robotronik/cdfr2019-2A/Electronique/Rolling_Base/Datasheets/Maxon_200142_Motor.png

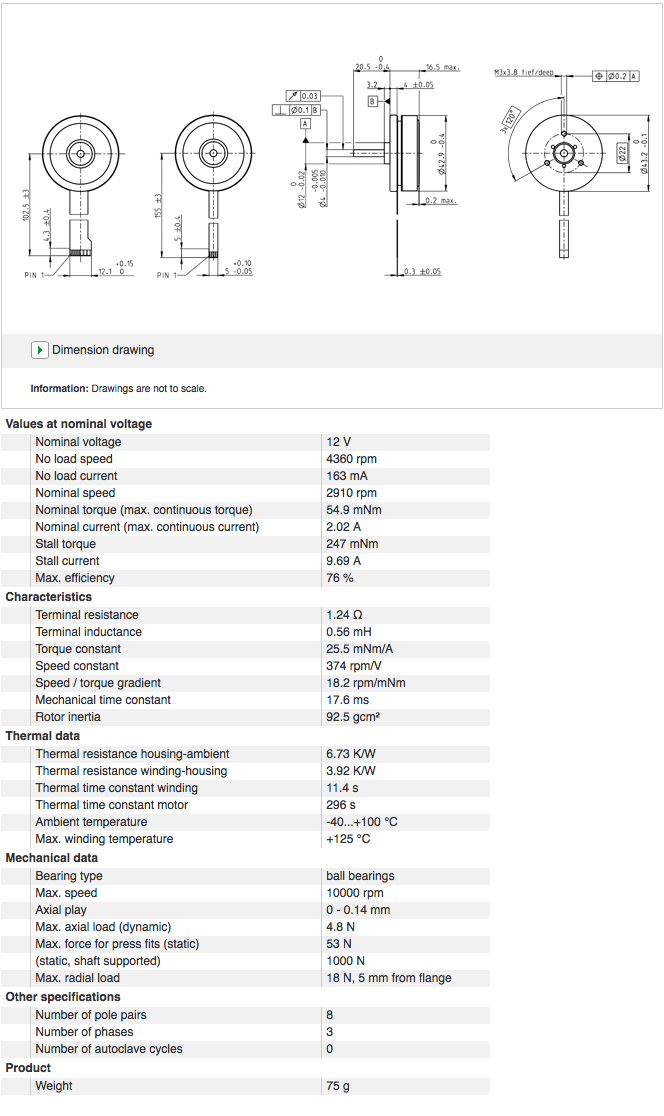
Electronique/Rolling_Base/Datasheets/Maxon_200142_Motor.png
