robotronik/cdfr2019-2A/Electronique/Power_Circuit/Power_Circuit.kicad_pcb

## KiCad design Electronique/Power_Circuit/Power_Circuit.kicad_pcb (2019-02-21)

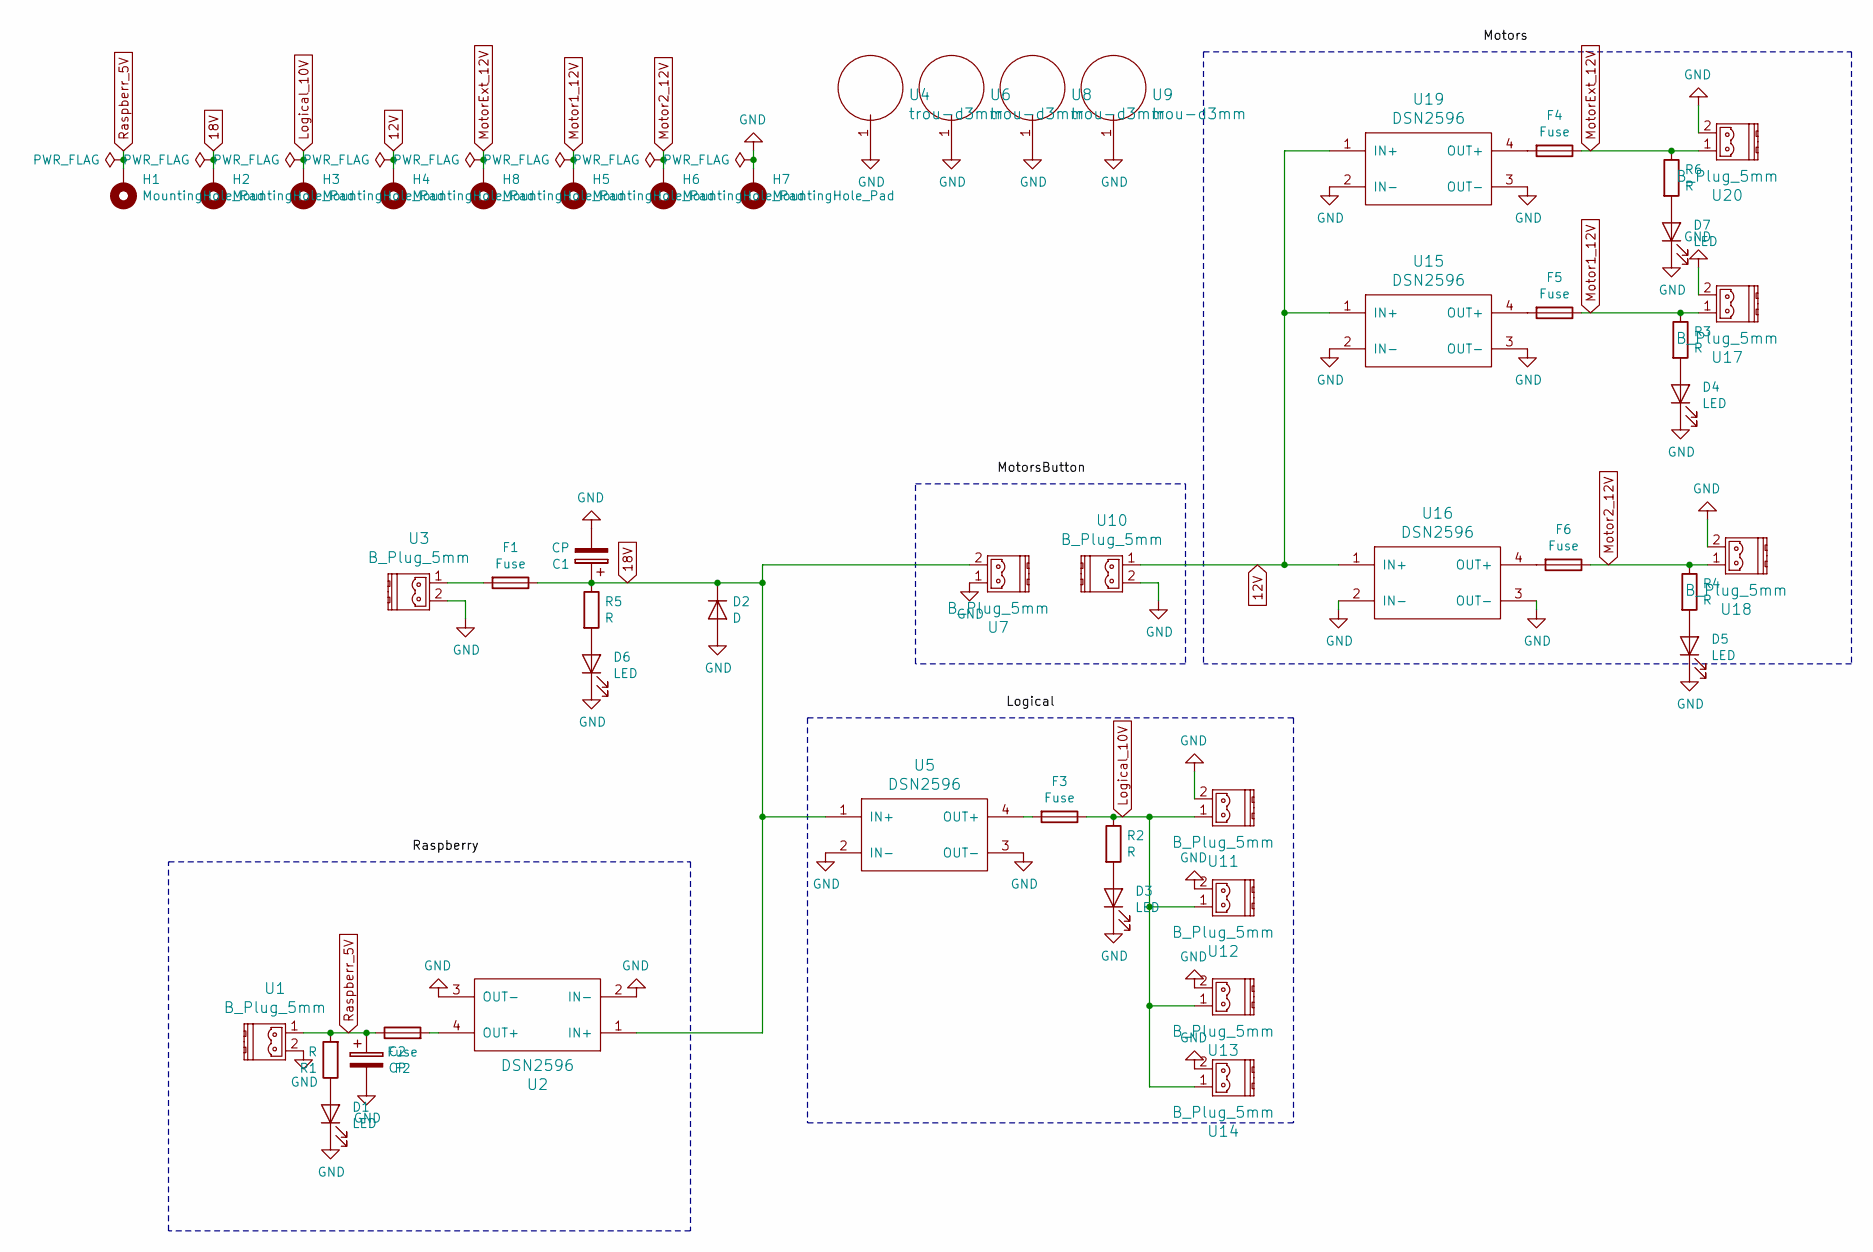
[picture p2: schematic Power_Circuit.sch]

Parts:
C1, C2: CP; CP_Radial_D8.0mm_P3.50mm
D1, D3, D4, D5, D6, D7: LED; LED_1206_3216Metric_Pad1.42x1.75mm_HandSolder
D2: D; D_DO-35_SOD27_P10.16mm_Horizontal
F1, F2, F3, F4, F5, F6: Fuse; Fuse_1206_3216Metric_Pad1.42x1.75mm_HandSolder
H1, H2, H3, H4, H5, H6, H7, H8: MountingHole_Pad; PinHeader_1x01_P1.00mm_Horizontal
R1, R2, R3, R4, R5, R6: R; R_1206_3216Metric_Pad1.42x1.75mm_HandSolder
U1, U3, U7, U10, U11, U12, U13, U14, U17, U18, U20: B_Plug_5mm; B plug 5mm
U2, U5, U15, U16, U19: DSN2596
U4, U6, U8, U9: trou-d3mm; trou_d3mm

Connections:
12V: H4.1, U10.1, U15.1 (IN+), U16.1 (IN+), U19.1 (IN+)
18V: C1.1, D2.1 (K), F1.1, H2.1, R5.1, U2.1 (IN+), U5.1 (IN+), U7.2
GND: C1.2, C2.2, D1.1 (K), D2.2 (A), D3.1 (K), D4.1 (K), D5.1 (K), D6.1 (K), D7.1 (K), H7.1, U1.2, U2.2 (IN-), U2.3 (OUT-), U3.2, U4.1, U5.2 (IN-), U5.3 (OUT-), U6.1, U7.1, U8.1, U9.1, U10.2, U11.2, U12.2, U13.2, U14.2, U15.2 (IN-), U15.3 (OUT-), U16.2 (IN-), U16.3 (OUT-), U17.2, U18.2, U19.2 (IN-), U19.3 (OUT-), U20.2
Logical_10V: F3.1, H3.1, R2.1, U11.1, U12.1, U13.1, U14.1
Motor1_12V: F5.1, H5.1, R3.1, U17.1
Motor2_12V: F6.1, H6.1, R4.1, U18.1
MotorExt_12V: F4.1, H8.1, R6.1, U20.1
unnamed: D1.2 (A), R1.1
unnamed: D3.2 (A), R2.2
unnamed: D4.2 (A), R3.2
unnamed: D5.2 (A), R4.2
unnamed: D6.2 (A), R5.2
unnamed: D7.2 (A), R6.2
unnamed: F1.2, U3.1
unnamed: F2.2, U2.4 (OUT+)
unnamed: F3.2, U5.4 (OUT+)
unnamed: F4.2, U19.4 (OUT+)
unnamed: F5.2, U15.4 (OUT+)
unnamed: F6.2, U16.4 (OUT+)
Raspberr_5V: C2.1, F2.1, H1.1, R1.2, U1.1

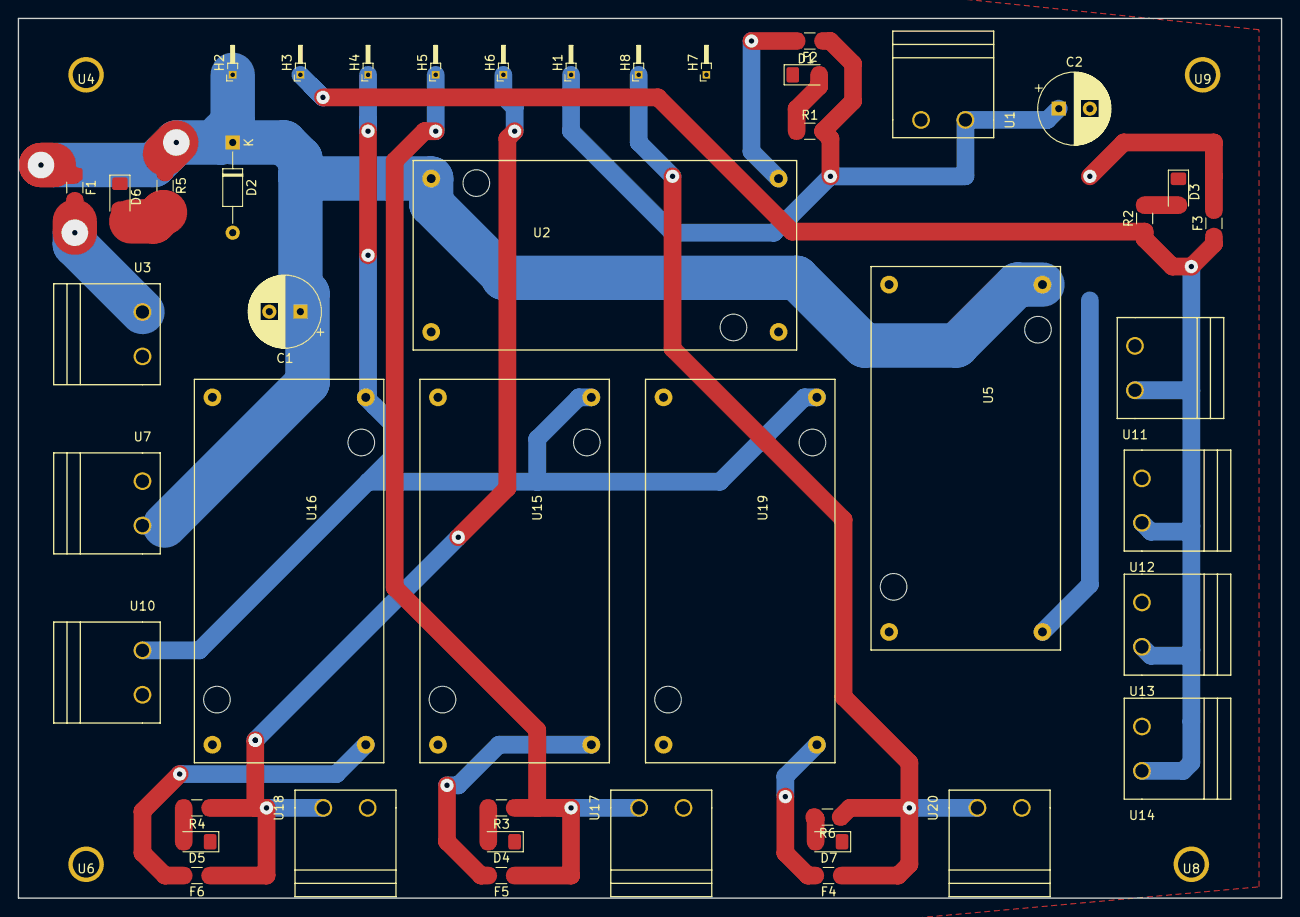
[picture p3: board Power_Circuit.kicad_pcb from above]

Board: 2 copper layers, 142.2 x 99.1 mm, 49 parts (0 on the bottom side), 20 nets.
