robotronik/cdfr2019-2A/Electronique/Rolling_Base/PCB/Motor_Card.kicad_pcb

## KiCad design Electronique/Rolling_Base/PCB/Motor_Card.kicad_pcb (2019-02-08)

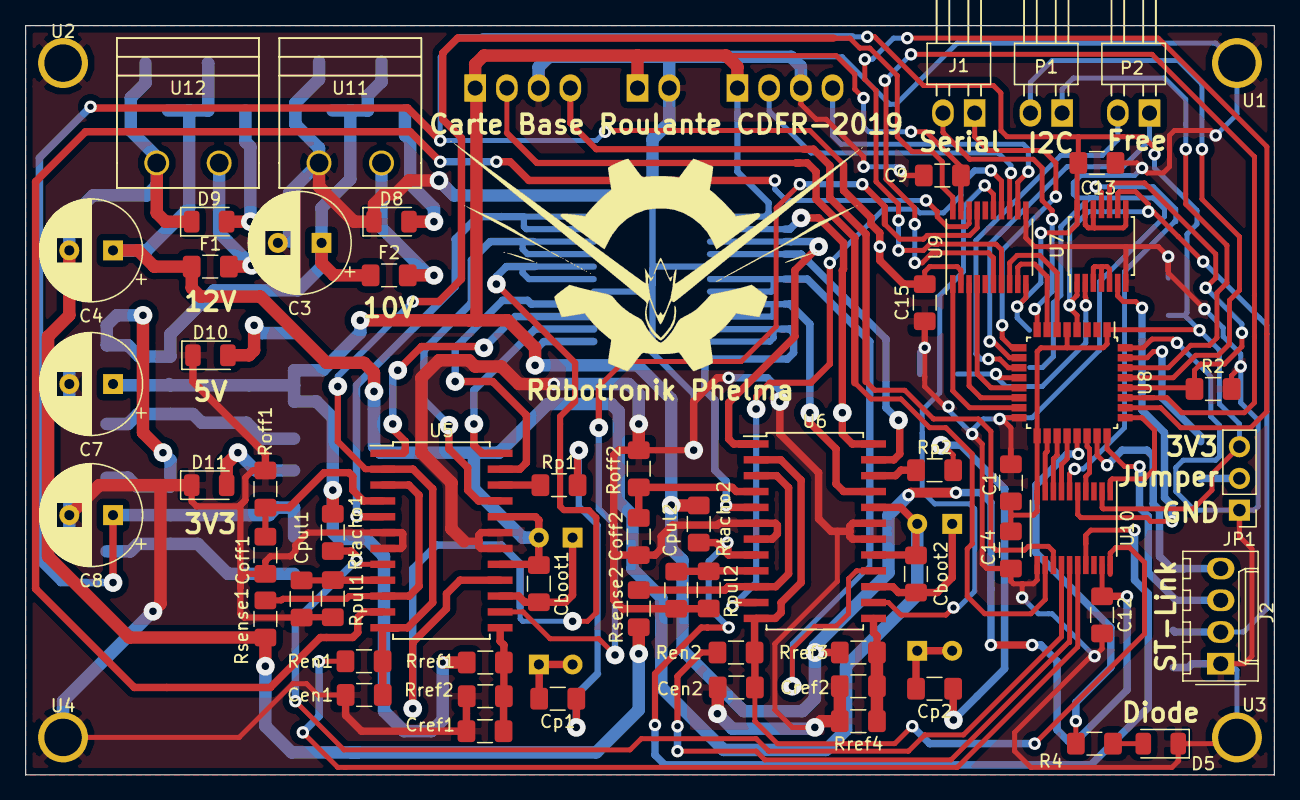
[picture p4: board Motor_Card.kicad_pcb from above]

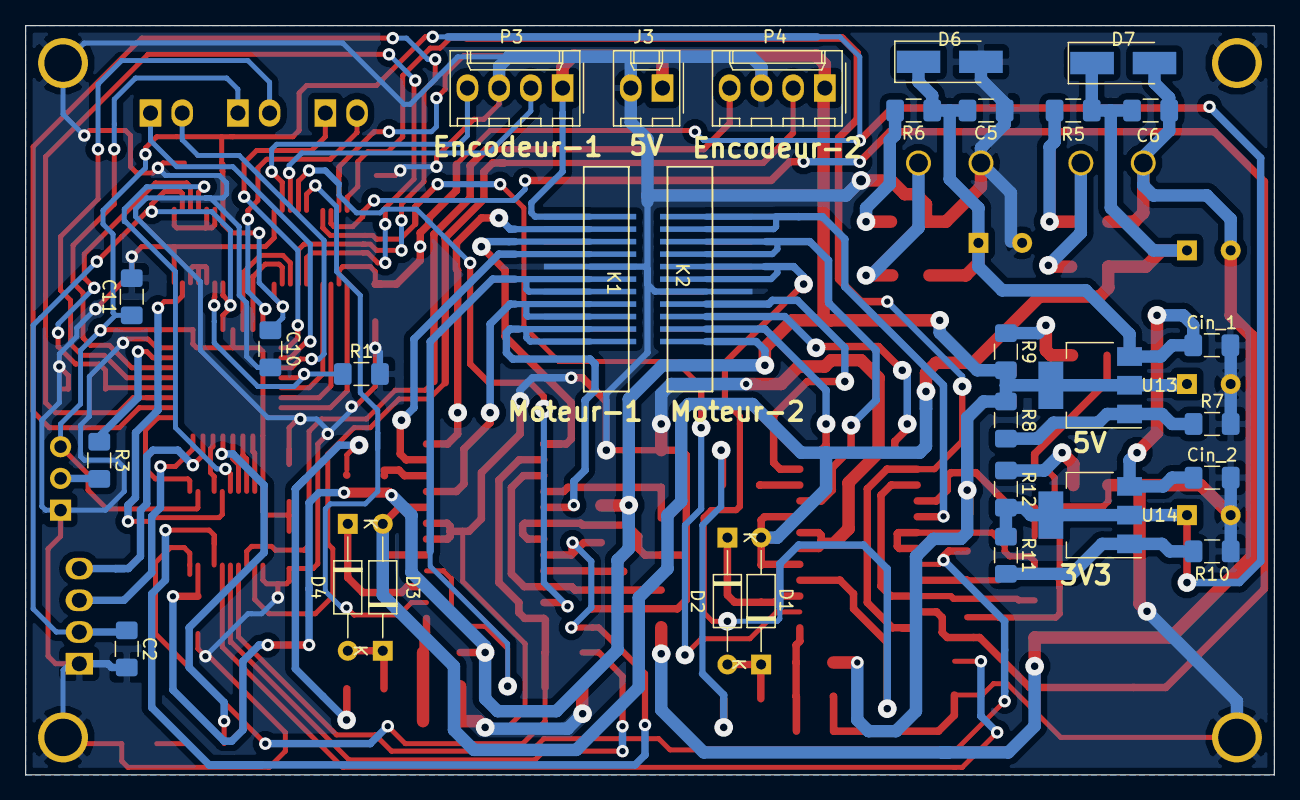
[picture p5: board Motor_Card.kicad_pcb from below]

Board: 2 copper layers, 100.0 x 60.0 mm, 94 parts (30 on the bottom side), 87 nets.

Parts:
C1, C2, C5, C6, C13, C14, C15: 100n; C_1206_3216Metric_Pad1.42x1.75mm_HandSolder
C3, C4: 100u; CP_Radial_D8.0mm_P3.50mm
C7, C8: 10u; CP_Radial_D8.0mm_P3.50mm
C9, C10, C11, C12: 0,1u; C_1206_3216Metric_Pad1.42x1.75mm_HandSolder
Cboot1, Cboot2: 220n; C_1206_3216Metric_Pad1.42x1.75mm_HandSolder
Cen1, Cen2: 5.6n; C_1206_3216Metric_Pad1.42x1.75mm_HandSolder
Cin_1, Cin_2: 0,1u; C_1206_3216Metric_Pad1.42x1.75mm_HandSolder
Coff1, Coff2: 1n; C_1206_3216Metric_Pad1.42x1.75mm_HandSolder
Cp1, Cp2: 10n; C_1206_3216Metric_Pad1.42x1.75mm_HandSolder
Cpul1, Cpul2: 10n; C_1206_3216Metric_Pad1.42x1.75mm_HandSolder
Cref1, Cref2: 10n; C_1206_3216Metric_Pad1.42x1.75mm_HandSolder
D1, D2, D3, D4: 1N4148; D_DO-35_SOD27_P10.16mm_Horizontal
D5, D9: LED_ALT; LED_1206_3216Metric
D6, D7: D_10A; D_SMA_Handsoldering
D8: LED_VCC; LED_1206_3216Metric
D10: LED_5V; LED_1206_3216Metric
D11: LED_3.3V; LED_1206_3216Metric
F1: Fuse_Puiss; Fuse_1206_3216Metric_Pad1.42x1.75mm_HandSolder
F2: Fuse_Num; Fuse_1206_3216Metric_Pad1.42x1.75mm_HandSolder
J1: CONN_SERIAL; Molex_KK-254_1x02_P2.54mm_Horizontal
J2: swdio; Molex_KK-254_AE-6410-04A_1x04_P2.54mm_Vertical
J3: FAN; Molex_KK-254_AE-6410-02A_1x02_P2.54mm_Vertical
JP1: Jumper_NC_Dual; PinHeader_1x03_P2.54mm_Vertical
K1, K2: Maxon-200142; Molex-52610-1133
P1: CONN_I2C; Molex_KK-254_1x02_P2.54mm_Horizontal
P2: CONN_FREE; Molex_KK-254_1x02_P2.54mm_Horizontal
P3: encoder_1; Molex_KK-254_AE-6410-04A_1x04_P2.54mm_Vertical
P4: encoder_2; Molex_KK-254_AE-6410-04A_1x04_P2.54mm_Vertical
R1, R2, R3: 10k; R_1206_3216Metric_Pad1.42x1.75mm_HandSolder
R4, R9, R12: 470; R_1206_3216Metric_Pad1.42x1.75mm_HandSolder
R5, R6: 2k; R_1206_3216Metric_Pad1.42x1.75mm_HandSolder
R7: 820; R_1206_3216Metric_Pad1.42x1.75mm_HandSolder
R8: 270; R_1206_3216Metric_Pad1.42x1.75mm_HandSolder
R10: 370; R_1206_3216Metric_Pad1.42x1.75mm_HandSolder
R11: 220; R_1206_3216Metric_Pad1.42x1.75mm_HandSolder
Ren1, Ren2: 100k; R_1206_3216Metric_Pad1.42x1.75mm_HandSolder
Roff1, Roff2: 33k; R_1206_3216Metric_Pad1.42x1.75mm_HandSolder
Rp1, Rp2: 100; R_1206_3216Metric_Pad1.42x1.75mm_HandSolder
Rpul1, Rpul2: 47k; R_1206_3216Metric_Pad1.42x1.75mm_HandSolder
Rref1, Rref3: 1.2k; R_1206_3216Metric_Pad1.42x1.75mm_HandSolder
Rref2, Rref4: 220; R_1206_3216Metric_Pad1.42x1.75mm_HandSolder
Rsense1, Rsense2: 0.3; R_1206_3216Metric_Pad1.42x1.75mm_HandSolder
Rtacho1, Rtacho2: 1k; R_1206_3216Metric_Pad1.42x1.75mm_HandSolder
U1, U2, U3, U4: Trou-3
U5, U6: L6235D; SOIC-24W_7.5x15.4mm_P1.27mm
U7: 74HC00; TSSOP-14_4.4x5mm_P0.65mm
U8: stm32f303k8t6; LQFP-32_7x7mm_P0.8mm
U9, U10: txb0108; TSSOP-20_4.4x6.5mm_P0.65mm
U11, U12: B_Plug_5mm; Bplug-5mm
U13, U14: LM317_SOT223; SOT-223-3_TabPin2

Connections:
+3V3: C1.2, C8.1, C10.1, C11.1, C13.1, C14.1, C15.2, JP1.3, R11.1, R12.2, U7.14, U8.1, U8.5, U8.17, U9.2, U9.10, U10.2, U10.10, U14.2
+5V: C7.1, C9.1, C12.1, J3.1, K1.11, K2.11, P3.1, P4.1, R8.1, R9.2, Rref1.1, Rref3.1, Rtacho1.1, Rtacho2.1, U9.19, U10.19, U13.2
+10V: C3.1, C5.1, Cin_1.1, Cin_2.1, D6.1, F2.1, R6.2, U13.3, U14.3
+12V: C4.1, C6.1, Cboot1.1, Cboot2.1, D1.2, D3.2, D7.1, F1.1, R5.2, U5.17, U5.20, U6.17, U6.20
/encodeurs/Ch_A1: U8.6, U9.8
/encodeurs/Ch_A1(+5V): P3.2, U9.13
/encodeurs/Ch_A2: U8.18, U10.9
/encodeurs/Ch_A2(+5V): P4.2, U10.12
/encodeurs/Ch_B1: U8.7, U9.9
/encodeurs/Ch_B1(+5V): P3.4, U9.12
/encodeurs/Ch_B2: U8.19, U10.8
/encodeurs/Ch_B2(+5V): P4.4, U10.13
/motor_part/BRAKE_1: U5.14, U9.17
/motor_part/BRAKE_2: U6.14, U9.15
/motor_part/DIAG_1: Cen1.2, Ren1.2, U5.2, U5.12, U9.20
/motor_part/DIAG_2: Cen2.2, Ren2.2, U6.2, U6.12, U10.20
/motor_part/DIR_1: U5.11, U9.18
/motor_part/DIR_2: U6.11, U9.14
/motor_part/EN_1: Ren1.1, U10.16
/motor_part/EN_2: Ren2.1, U10.15
/motor_part/Hall_sensor_11: K1.9, U5.1
/motor_part/Hall_sensor_12: K2.9, U6.1
/motor_part/Hall_sensor_21: K1.8, U5.23
/motor_part/Hall_sensor_22: K2.8, U6.23
/motor_part/Hall_sensor_31: K1.10, U5.24
/motor_part/Hall_sensor_32: K2.10, U6.24
/motor_part/Out_11: K1.1, K1.2, U5.5
/motor_part/Out_12: K2.1, K2.2, U6.5
/motor_part/Out_21: K1.3, K1.4, U5.21
/motor_part/Out_22: K2.3, K2.4, U6.21
/motor_part/Out_31: K1.5, K1.6, U5.16
/motor_part/Out_33: K2.5, K2.6, U6.16
/motor_part/TACHO_1: Rtacho1.2, U5.8, U10.14
/motor_part/TACHO_2: Rtacho2.2, U6.8, U10.17
/power_part/Alim_num: F2.2, U11.1
/power_part/Alim_puiss: F1.2, U12.1
/uC/Brake_1(3V3): U8.13, U9.4
/uC/Brake_2(3V3): U8.27, U9.6
/uC/Cmd_En_1(3V3): R1.1, U7.2, U8.12
/uC/Cmd_En_2(3V3): R2.1, U7.10, U8.28
/uC/Diag_1(3V3): U8.15, U9.1
/uC/Diag_2(3V3): U8.25, U10.1
/uC/Dir_1(3V3): U8.14, U9.3
/uC/Dir_2(3V3): U8.26, U9.7
/uC/Free_1(3V3): P2.1, U8.10
/uC/Free_2(3V3): P2.2, U8.11
/uC/I2C_SCL(3V3): P1.2, U8.29
/uC/I2C_SDA(3V3): P1.1, U8.30
/uC/RX(3V3): J1.1, U8.9
/uC/TX(3V3): J1.2, U8.8
/uC/Tacho_1(3V3): U8.20, U10.7
/uC/Tacho_2(3V3): U8.22, U10.4
/uC/nrst(3V3): C2.1, J2.2, U7.1, U7.9, U8.4
/uC/swclk(3V3): J2.3, U8.24
/uC/swdio(3V3): J2.4, U8.23
GND: C1.1, C2.2, C3.2, C5.2, C7.2, C8.2, C9.2, C10.2, C11.2, C12.2, C13.2, C14.2, C15.1, Cen1.1, Cen2.1, Cin_1.2, Cin_2.2, Coff1.1, Coff2.1, Cpul1.1, Cpul2.1, Cref1.2, Cref2.2, D5.1, D6.2, D8.1, D10.1, D11.1, J2.1, J3.2, JP1.1, K1.7, K2.7, P3.3, P4.3, R1.2, R2.2, R7.2, R10.1, Roff1.1, Roff2.1, Rpul1.1, Rpul2.1, Rref2.2, Rref4.2, U1.1, U2.1, U3.1, U4.1, U5.6, U5.7, U5.18, U5.19, U6.6, U6.7, U6.18, U6.19, U7.7, U8.16, U8.32, U9.11, U10.11, U11.2
GNDPWR: C4.2, C6.2, D7.2, D9.1, Rsense1.2, Rsense2.2, U12.2
unnamed: Cboot1.2, D2.1, U5.15
unnamed: Cboot2.2, D4.1, U6.15
unnamed: Coff1.2, Roff1.2, U5.4
unnamed: Coff2.2, Roff2.2, U6.4
unnamed: Cp1.1, Rp1.2
unnamed: Cp1.2, D1.1, D2.2
unnamed: Cp2.1, Rp2.2
unnamed: Cp2.2, D3.1, D4.2
unnamed: Cpul1.2, Rpul1.2, U5.9
unnamed: Cpul2.2, Rpul2.2, U6.9
unnamed: Cref1.1, Rref1.2, Rref2.1, U5.13
unnamed: Cref2.1, Rref3.2, Rref4.1, U6.13
unnamed: D5.2, R4.2
unnamed: D8.2, R6.1
unnamed: D9.2, R5.1
unnamed: D10.2, R9.1
unnamed: D11.2, R12.1
unnamed: JP1.2, R3.2
unnamed: R3.1, U8.31
unnamed: R4.1, U8.21
unnamed: R7.1, R8.2, U13.1
unnamed: R10.2, R11.2, U14.1
unnamed: Rp1.1, U5.22
unnamed: Rp2.1, U6.22
unnamed: Rsense1.1, U5.3, U5.10
unnamed: Rsense2.1, U6.3, U6.10
unnamed: U7.3, U7.4, U7.5
unnamed: U7.8, U7.12, U7.13
unnamed: U7.6, U10.5
unnamed: U7.11, U10.6
