robotronik/cdfr2019-2A/(threads)

Thread 8 (2019-01-16):

Gestion des branches

Salamandar, 2019-01-16:
Pourquoi vous réunissez élec, méca, et info dans le même repo en faisant plusieurs branches ? C'est pas le design de git !
Faites plusieurs repos, et utilisez les branches pour les features.

Thread 9 (2019-01-31):

Review des pull request (pour l'info)

robinmoussu, 2019-01-31:
Bonjour,
Je suis un ancien dev du club robot (même génération que Félix).
Si vous êtes intéressé, je peux faire des review du code que vous pusher sur le repo.
Robin
