robotronik/cdfr2019-2A/Electronique/Rolling_Base/prop.ioc

Mcu.UserName=STM32F303K8Tx
PA0.Signal=S_TIM2_CH1_ETR
PA1.Signal=S_TIM2_CH2
PA10.GPIO_Label=TACHO_1
PA10.Signal=GPIO_Input
PA11.GPIO_Label=LED
PA11.Signal=GPIO_Output
PA12.GPIO_Label=TACHO_2
PA12.Signal=GPIO_Input
PA15.GPIO_Label=DIAG_2
PA15.Signal=GPIO_Input
PA2.Signal=USART2_TX
PA3.Signal=USART2_RX
PA6.GPIO_Label=EN_1
PA6.Signal=S_TIM16_CH1
PA7.GPIO_Label=BRAKE_1
PA7.Signal=S_TIM3_CH2
PA8.Signal=S_TIM1_CH1
PA9.Signal=S_TIM1_CH2
PB0.GPIO_Label=DIR_1
PB0.Signal=GPIO_Output
PB1.GPIO_Label=DIAG_1
PB1.Signal=GPIO_Input
PB3.GPIO_Label=DIR_2
PB3.Signal=GPIO_Output
PB4.GPIO_Label=BRAKE_2
PB4.Signal=S_TIM3_CH1
PB5.GPIO_Label=EN_2
PB5.Signal=S_TIM17_CH1
PB6.Signal=I2C1_SCL
PB7.Signal=I2C1_SDA
