robotronik/cdfr2019-2A/(commit log)

2018-11-16 Setup for the PID
    [gdb-pipe.cfg, st_nucleo_f3.cfg, st_nucleo_f4.cfg]
2018-11-16 PID macros
2018-11-22 premier increment sur le devpment du pid, il reste le code du main , le code du pid a verifier
2018-11-29 Fixed pid and add pid control in the main
    [main.c]
2018-12-06 Fix PID errors
2019-01-10 [ Electronik ] Realization of the electric schemes - Modification of the old rolling base card - Add of motor stop during reset - Conversion of tension (3V3) to the stm Commit before route
    [Motor_Card-2018-11-30-18-44-23.sch, Motor_Card-2018-11-30-18-52-03.sch, Motor_Card-2018-11-30-19-51-16.sch, Motor_Card-2018-11-30-19-52-23.sch, Motor_Card-2018-11-30-19-54-01.sch, Motor_Card.kicad_pcb, Motor_Card.sch, Motor_Card_Old.kicad_pcb]
2019-01-30 Add lib
    [Power_Circuit.kicad_pcb, Power_Circuit.sch]
2019-02-01 cleanup of Kicad files, add gitignore
    [Motor_Card-2018-11-30-18-44-23.sch, Motor_Card-2018-11-30-18-52-03.sch, Motor_Card-2018-11-30-19-51-16.sch, Motor_Card-2018-11-30-19-52-23.sch, Motor_Card-2018-11-30-19-54-01.sch, Motor_Card_Old.kicad_pcb, encodeurs-2018-11-30-18-44-23.sch, encodeurs-2018-11-30-18-52-03.sch]
2019-02-01 Utilisation de chemin relatif au projet pour les librairies
    [Motor_Card.sch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]
2019-02-08 Final Rolling Base Card
    [Motor_Card-V1.kicad_pcb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]
2019-02-08 Circuit adjustement
    [Power_Circuit.kicad_pcb, Power_Circuit.sch]
2019-02-21 quick fix
    [Power_Circuit.kicad_pcb]
